eTextile/Matrix/Software/README.md

# E256 - Demo software

For an explanation of the E256 communication protocol see the [FIRMWARE_README](../Firmware/README.md "FIRMWARE_README")

- [Pure_data](http://puredata.info/downloads "puredata.info")
  - SLIP-OSC driver
    - This patch depends on several third party externals available through deken plugin (Help -> Find externals):
	- comport : 
	- mrpeach : OSC slipenc and slipdec
	- cyclone : 
- [openFrameworks](https://openframeworks.cc/ "openFrameworks.cc")
  - SLIP-OSC driver
- [Supercollider](https://supercollider.github.io/ "Supercollider.io") - FIXME
  - SLIP-OSC driver
- [Processing](https://processing.org/ "Processing.org") - TODO
  - SLIP-OSC driver
- [MaxMSP](https://cycling74.com/ "cycling74.com") - TODO
  - SLIP-OSC driver
- [VVVVV](https://vvvv.org/downloads "vvvv.org") - TODO?
  - SLIP-OSC driver

# E256 data stream samples (SLIP-OSC)

Sample input:
Code:
~~~~```
INPUT (tree blobs) : 
35 98 117 110 100 108 101 0 0 0 0 0 0 0 0 0 0 0 0 20 47 98 0 0 44 98 0 0 0 0 0 7 0 1 44 49 6 12 181 0 0 0 0 20 47 98 0 0 44 98 0 0 0 0 0 7 1 1 18 27 10 10 221 0 0 0 0 20 47 98 0 0 44 98 0 0 0 0 0 7 2 1 40 32 6 10 203 0
```

~~~~```
0 	: 35 = "#"
1 	: 98 = "b"
2 	: 117 = "u"
3 	: 110 = "n"
4 	: 100 = "d"
5 	: 108 = "l"
6 	: 101 = "e"
7 	: O
8 	: 0
9 	: 0
10 	: 0
11  : 0
12  : 0
13  : 0
14  : 0
15  : 0
16  : 0
17  : 0
18  : 0
19  : 20
20  : 47 = "/"
21  : 98 = "b"
22  : 0
23  : 0
24  : 44
25  : 98
26  : 0
27  : 0
28  : 0
29  : 0
30  : 0
31  : 7
32  : BYTE -> UID
33  : BYTE -> alive
34  : BYTE -> Xcentroid
35  : BYTE -> Ycentroid
36  : BYTE -> box.H
37  : BYTE -> box.W
38  : BYTE -> box.D
39  : 0
40  : 0
41  : 0
42  : 0
43  : 20
44  : 47 = "/"
45  : 98 = "b"
...

```

# E256 data stream samples (SLIP-OSC)

~~~~```
print: 35 98 117 110 100 108 101 0 0 0 0 0 0 0 0 0
print: 35 98 117 110 100 108 101 0 0 0 0 0 0 0 0 0
print: 35 98 117 110 100 108 101 0 0 0 0 0 0 0 0 0
print: 35 98 117 110 100 108 101 0 0 0 0 0 0 0 0 0
print: 35 98 117 110 100 108 101 0 0 0 0 0 0 0 0 0
print: 35 98 117 110 100 108 101 0 0 0 0 0 0 0 0 0
print: 35 98 117 110 100 108 101 0 0 0 0 0 0 0 0 0
print: 35 98 117 110 100 108 101 0 0 0 0 0 0 0 0 0
print: 35 98 117 110 100 108 101 0 0 0 0 0 0 0 0 0
print: 35 98 117 110 100 108 101 0 0 0 0 0 0 0 0 0
print: 35 98 117 110 100 108 101 0 0 0 0 0 0 0 0 0
print: 35 98 117 110 100 108 101 0 0 0 0 0 0 0 0 0 0 0 0 20 47 98 0 0 44 98 0 0 0 0 0 7 0 1 44 47 6 10 154 0
print: 35 98 117 110 100 108 101 0 0 0 0 0 0 0 0 0 0 0 0 20 47 98 0 0 44 98 0 0 0 0 0 7 0 1 44 46 6 9 153 0
print: 35 98 117 110 100 108 101 0 0 0 0 0 0 0 0 0 0 0 0 20 47 98 0 0 44 98 0 0 0 0 0 7 0 1 44 47 7 10 162 0
print: 35 98 117 110 100 108 101 0 0 0 0 0 0 0 0 0 0 0 0 20 47 98 0 0 44 98 0 0 0 0 0 7 0 1 43 47 8 10 175 0
print: 35 98 117 110 100 108 101 0 0 0 0 0 0 0 0 0 0 0 0 20 47 98 0 0 44 98 0 0 0 0 0 7 0 1 44 47 6 11 188 0
print: 35 98 117 110 100 108 101 0 0 0 0 0 0 0 0 0 0 0 0 20 47 98 0 0 44 98 0 0 0 0 0 7 0 1 44 49 6 12 197 0
print: 35 98 117 110 100 108 101 0 0 0 0 0 0 0 0 0 0 0 0 20 47 98 0 0 44 98 0 0 0 0 0 7 0 1 44 49 6 12 191 0
print: 35 98 117 110 100 108 101 0 0 0 0 0 0 0 0 0 0 0 0 20 47 98 0 0 44 98 0 0 0 0 0 7 0 1 44 49 7 12 188 0
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
print: 35 98 117 110 100 108 101 0 0 0 0 0 0 0 0 0 0 0 0 20 47 98 0 0 44 98 0 0 0 0 0 7 0 1 44 49 6 12 178 0 0 0 0 20 47 98 0 0 44 98 0 0 0 0 0 7 1 1 18 27 10 10 217 0 0 0 0 20 47 98 0 0 44 98 0 0 0 0 0 7 2 1 40 32 6 10 205 0
print: 35 98 117 110 100 108 101 0 0 0 0 0 0 0 0 0 0 0 0 20 47 98 0 0 44 98 0 0 0 0 0 7 0 1 44 49 6 12 181 0 0 0 0 20 47 98 0 0 44 98 0 0 0 0 0 7 1 1 18 27 10 10 220 0 0 0 0 20 47 98 0 0 44 98 0 0 0 0 0 7 2 1 40 32 6 10 205 0
print: 35 98 117 110 100 108 101 0 0 0 0 0 0 0 0 0 0 0 0 20 47 98 0 0 44 98 0 0 0 0 0 7 0 1 44 49 6 12 181 0 0 0 0 20 47 98 0 0 44 98 0 0 0 0 0 7 1 1 18 27 10 10 221 0 0 0 0 20 47 98 0 0 44 98 0 0 0 0 0 7 2 1 40 32 6 10 203 0
```
