eTextile/Matrix/Eagle/eTextile_matrix_sensor.brd

## EAGLE design Eagle/eTextile_matrix_sensor.brd (2016-10-07, last stored version)

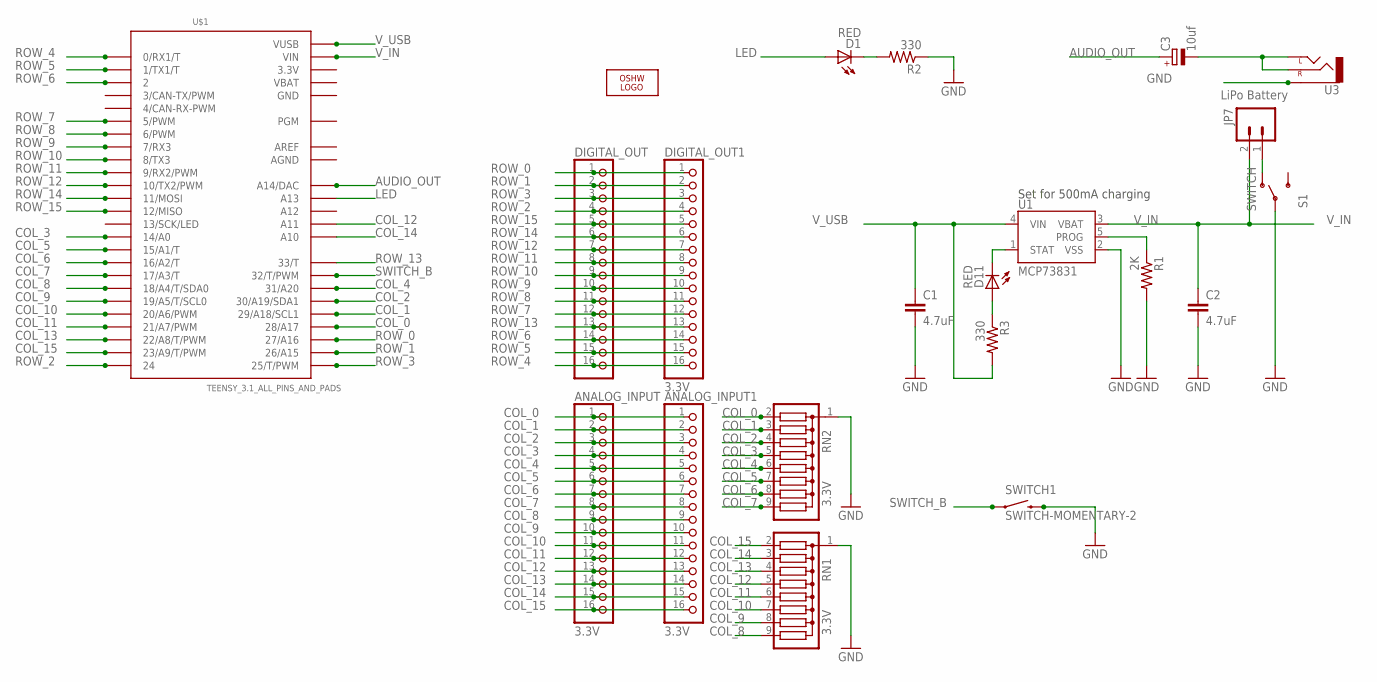
[picture p3: schematic eTextile_matrix_sensor.sch]

Parts:
ANALOG_INPUT: 3.3V; 1X16/90
ANALOG_INPUT1: 3.3V; 1X16
C1, C2: 4.7uF; 0805
C3: 10uf; E1,8-4
D1, D11: RED; LED-1206
DIGITAL_OUT: PINHD-1X16/90; 1X16/90
DIGITAL_OUT1: 3.3V; 1X16/90
JP7: LiPo Battery; JST-2-SMD
LOGO1: OSHW_LOGO_8MILX0350-NT; OSHW_8X350_NOTEXT
R1: 2K; 0805
R2, R3: 330; 0805
RN1, RN2: 3.3V; SIL9
S1: SWITCH; AYZ0202
SWITCH1: SWITCH-MOMENTARY-2; TACTILE_SWITCH_TALL
U1: MCP73831; SOT23-5
U3: AUDIO-JACKSMD2; AUDIO-JACK-3.5MM-SMD
U$1: TEENSY_3.1_ALL_PINS_AND_PADS; TEENSY_3.1_ALLPINS

Connections:
3.3V: U$1.3.3V, U$1.3.3V1 (3.3V), U$1.3.3V2 (3.3V)
AGND: U$1.AGND
AREF: U$1.AREF
AUDIO_OUT: C3.+, U$1.A14 (A14/DAC)
COL_0: ANALOG_INPUT.1, ANALOG_INPUT1.1, RN2.2, U$1.28 (28/A17)
COL_1: ANALOG_INPUT.2, ANALOG_INPUT1.2, RN2.3, U$1.29 (29/A18/SCL1)
COL_2: ANALOG_INPUT.3, ANALOG_INPUT1.3, RN2.4, U$1.30 (30/A19/SDA1)
COL_3: ANALOG_INPUT.4, ANALOG_INPUT1.4, RN2.5, U$1.14/A0
COL_4: ANALOG_INPUT.5, ANALOG_INPUT1.5, RN2.6, U$1.31 (31/A20)
COL_5: ANALOG_INPUT.6, ANALOG_INPUT1.6, RN2.7, U$1.15/A1 (15/A1/T)
COL_6: ANALOG_INPUT.7, ANALOG_INPUT1.7, RN2.8, U$1.16/A2 (16/A2/T)
COL_7: ANALOG_INPUT.8, ANALOG_INPUT1.8, RN2.9, U$1.17/A3 (17/A3/T)
COL_8: ANALOG_INPUT.9, ANALOG_INPUT1.9, RN1.9, U$1.18/A4 (18/A4/T/SDA0)
COL_9: ANALOG_INPUT.10, ANALOG_INPUT1.10, RN1.8, U$1.19/A5 (19/A5/T/SCL0)
COL_10: ANALOG_INPUT.11, ANALOG_INPUT1.11, RN1.7, U$1.20/A6 (20/A6/PWM)
COL_11: ANALOG_INPUT.12, ANALOG_INPUT1.12, RN1.6, U$1.21/A7 (21/A7/PWM)
COL_12: ANALOG_INPUT.13, ANALOG_INPUT1.13, RN1.5, U$1.A11
COL_13: ANALOG_INPUT.14, ANALOG_INPUT1.14, RN1.4, U$1.22/A8 (22/A8/T/PWM)
COL_14: ANALOG_INPUT.15, ANALOG_INPUT1.15, RN1.3, U$1.A10
COL_15: ANALOG_INPUT.16, ANALOG_INPUT1.16, RN1.2, U$1.23/A9 (23/A9/T/PWM)
GND: C1.2, C2.2, R1.2, R2.1, RN1.1, RN2.1, S1.2, SWITCH1.B2 (2), U1.2 (VSS), U3.SLEEVE, U$1.GND, U$1.GND1 (GND), U$1.GND2 (GND)
LED: D1.A, U$1.A13
unnamed: C3.-, U3.RING (RIGHT), U3.TIP (LEFT)
unnamed: D11.A, R3.1
unnamed: JP7.1, S1.1 (O)
unnamed: D1.C, R2.2
PROG: R1.1, U1.5 (PROG)
ROW_0: DIGITAL_OUT.1, DIGITAL_OUT1.1, U$1.27 (27/A16)
ROW_1: DIGITAL_OUT.2, DIGITAL_OUT1.2, U$1.26 (26/A15)
ROW_2: DIGITAL_OUT.4, DIGITAL_OUT1.4, U$1.24
ROW_3: DIGITAL_OUT.3, DIGITAL_OUT1.3, U$1.25 (25/T/PWM)
ROW_4: DIGITAL_OUT.16, DIGITAL_OUT1.16, U$1.0 (0/RX1/T)
ROW_5: DIGITAL_OUT.15, DIGITAL_OUT1.15, U$1.1 (1/TX1/T)
ROW_6: DIGITAL_OUT.14, DIGITAL_OUT1.14, U$1.2
ROW_7: DIGITAL_OUT.12, DIGITAL_OUT1.12, U$1.5 (5/PWM)
ROW_8: DIGITAL_OUT.11, DIGITAL_OUT1.11, U$1.6 (6/PWM)
ROW_9: DIGITAL_OUT.10, DIGITAL_OUT1.10, U$1.7 (7/RX3)
ROW_10: DIGITAL_OUT.9, DIGITAL_OUT1.9, U$1.8 (8/TX3)
ROW_11: DIGITAL_OUT.8, DIGITAL_OUT1.8, U$1.9 (9/RX2/PWM)
ROW_12: DIGITAL_OUT.7, DIGITAL_OUT1.7, U$1.10 (10/TX2/PWM)
ROW_13: DIGITAL_OUT.13, DIGITAL_OUT1.13, U$1.33 (33/T)
ROW_14: DIGITAL_OUT.6, DIGITAL_OUT1.6, U$1.11 (11/MOSI)
ROW_15: DIGITAL_OUT.5, DIGITAL_OUT1.5, U$1.12 (12/MISO)
STAT: D11.C, U1.1 (STAT)
SWITCH_B: SWITCH1.A2 (1), U$1.32 (32/T/PWM)
VBAT: U$1.VBAT
V_IN: C2.1, JP7.2, U1.3 (VBAT), U$1.VIN
V_USB: C1.1, R3.2, U1.4 (VIN), U$1.VUSB

Notes on the sheet:
Set for 500mA charging

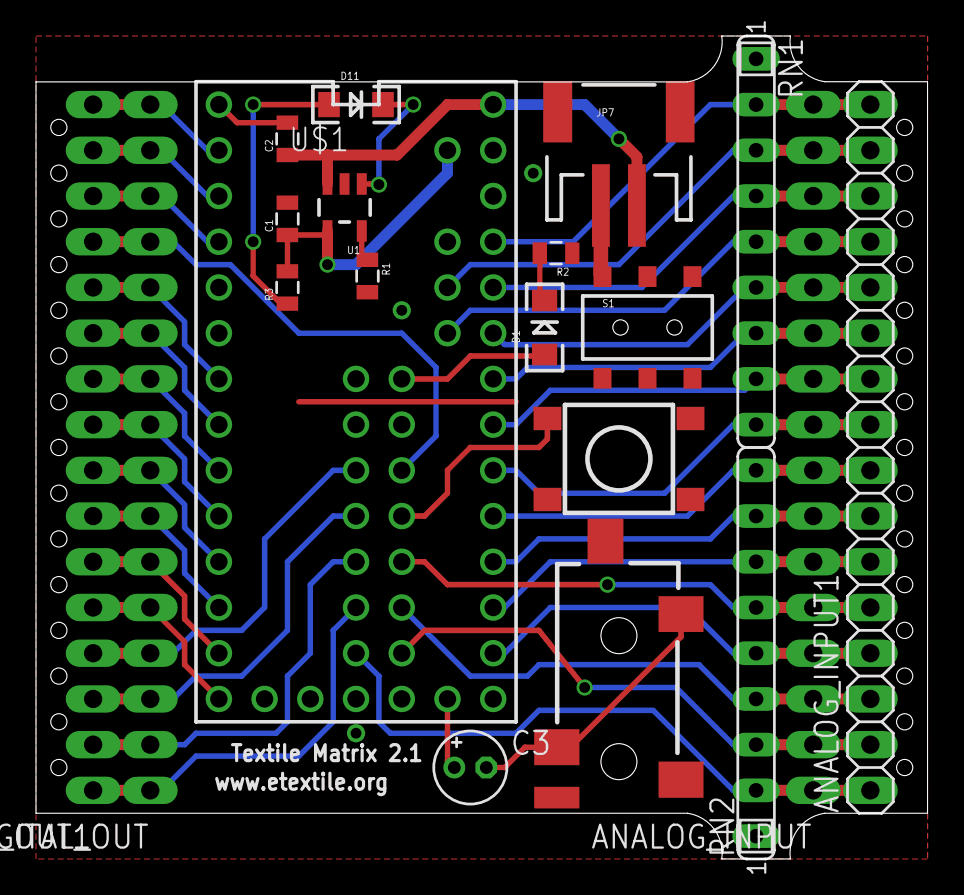
[picture p4: board eTextile_matrix_sensor.brd from above]

Board: 2 copper layers, 49.5 x 45.7 mm, 21 parts (0 on the bottom side), 45 nets.
