eTextile/Matrix/Eagle/Arduio_matrix-shield_02.brd

## EAGLE design Eagle/Arduio_matrix-shield_02.brd (2014-09-01, last stored version)

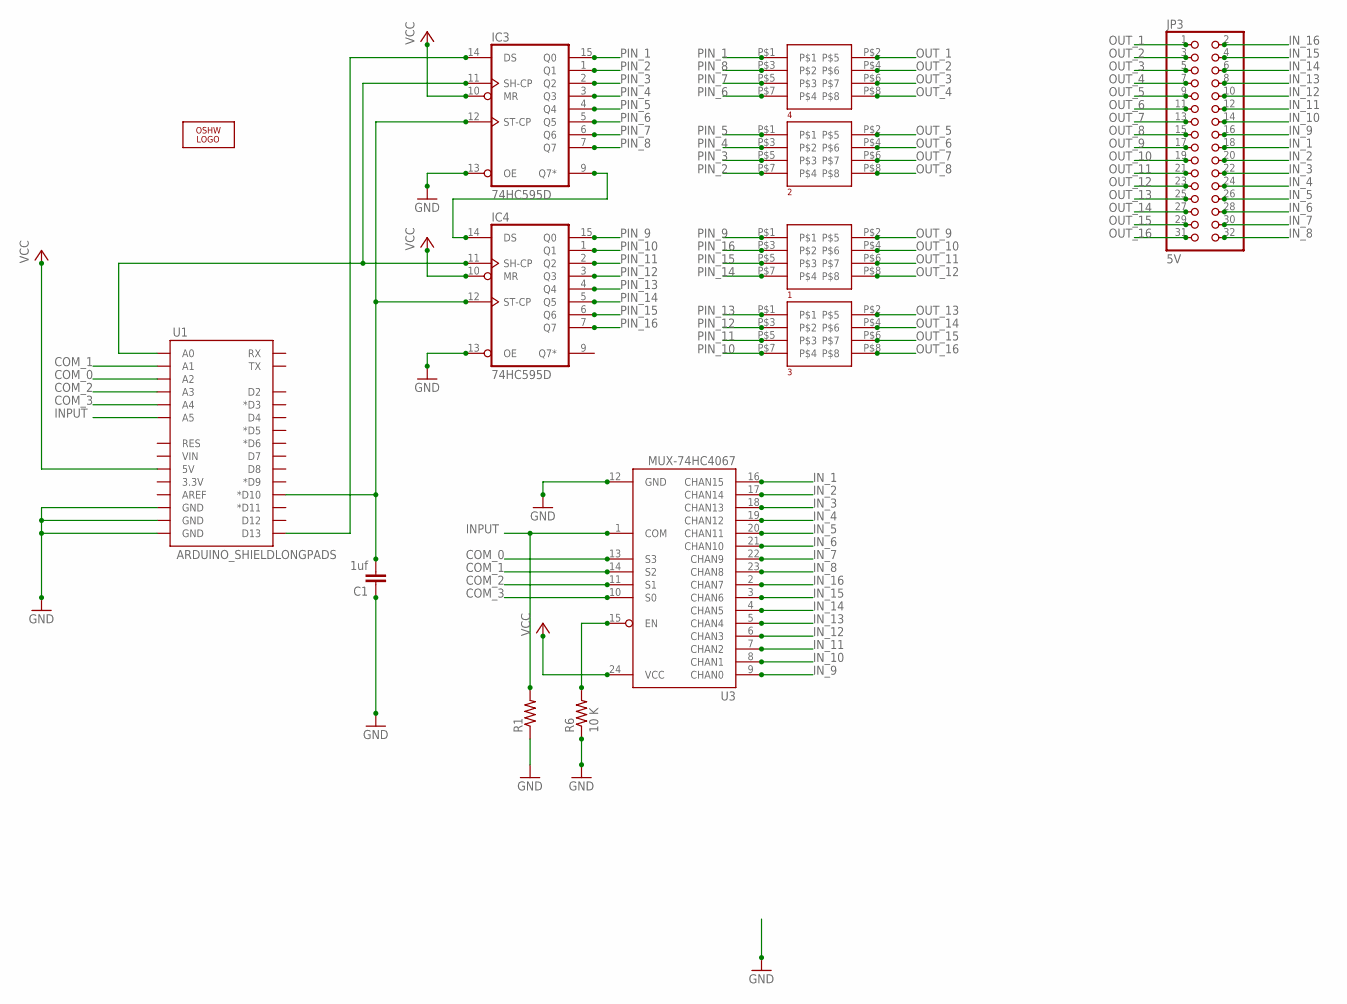
[picture p5: schematic Arduio_matrix-shield_02.sch]

Parts:
1, 2, 3, 4: D83A
C1: 1uf; 1206
IC3, IC4: 74HC595D; SO16
JP3: 5V; 2X16/90
OSHW: OSHW_LOGO_8MILX0350-NT; OSHW_8X350_NOTEXT
R1: R-US_0204/7; 0204/7
R6: 10 K; 1206
U1: ARDUINO_SHIELDLONGPADS; DUEMILANOVE_SHIELD_LONGPADS
U3: MUX-74HC4067; SSOP24

Connections:
COM_0: U1.A2, U3.13 (S3)
COM_1: U1.A1, U3.14 (S2)
COM_2: U1.A3, U3.11 (S1)
COM_3: U1.A4, U3.10 (S0)
GND: C1.1, IC3.8 (GND), IC3.13 (OE), IC4.8 (GND), IC4.13 (OE), R1.1, R6.1, U1.GND@0 (GND), U1.GND@1 (GND), U1.GND@2 (GND), U3.12 (GND)
INPUT: R1.2, U1.A5, U3.1 (COM)
IN_1: JP3.18, U3.16 (CHAN15)
IN_2: JP3.20, U3.17 (CHAN14)
IN_3: JP3.22, U3.18 (CHAN13)
IN_4: JP3.24, U3.19 (CHAN12)
IN_5: JP3.26, U3.20 (CHAN11)
IN_6: JP3.28, U3.21 (CHAN10)
IN_7: JP3.30, U3.22 (CHAN9)
IN_8: JP3.32, U3.23 (CHAN8)
IN_9: JP3.16, U3.9 (CHAN0)
IN_10: JP3.14, U3.8 (CHAN1)
IN_11: JP3.12, U3.7 (CHAN2)
IN_12: JP3.10, U3.6 (CHAN3)
IN_13: JP3.8, U3.5 (CHAN4)
IN_14: JP3.6, U3.4 (CHAN5)
IN_15: JP3.4, U3.3 (CHAN6)
IN_16: JP3.2, U3.2 (CHAN7)
unnamed: IC3.9 (Q7*), IC4.14 (DS)
unnamed: R6.2, U3.15 (EN)
unnamed: IC3.11 (SH-CP), IC4.11 (SH-CP), U1.A0
unnamed: C1.2, IC3.12 (ST-CP), IC4.12 (ST-CP), U1.D10 (*D10)
unnamed: IC3.14 (DS), U1.D13
OUT_1: 4.P$2, JP3.1
OUT_2: 4.P$4, JP3.3
OUT_3: 4.P$6, JP3.5
OUT_4: 4.P$8, JP3.7
OUT_5: 2.P$2, JP3.9
OUT_6: 2.P$4, JP3.11
OUT_7: 2.P$6, JP3.13
OUT_8: 2.P$8, JP3.15
OUT_9: 1.P$2, JP3.17
OUT_10: 1.P$4, JP3.19
OUT_11: 1.P$6, JP3.21
OUT_12: 1.P$8, JP3.23
OUT_13: 3.P$2, JP3.25
OUT_14: 3.P$4, JP3.27
OUT_15: 3.P$6, JP3.29
OUT_16: 3.P$8, JP3.31
PIN_1: 4.P$1, IC3.15 (Q0)
PIN_2: 2.P$7, IC3.1 (Q1)
PIN_3: 2.P$5, IC3.2 (Q2)
PIN_4: 2.P$3, IC3.3 (Q3)
PIN_5: 2.P$1, IC3.4 (Q4)
PIN_6: 4.P$7, IC3.5 (Q5)
PIN_7: 4.P$5, IC3.6 (Q6)
PIN_8: 4.P$3, IC3.7 (Q7)
PIN_9: 1.P$1, IC4.15 (Q0)
PIN_10: 3.P$7, IC4.1 (Q1)
PIN_11: 3.P$5, IC4.2 (Q2)
PIN_12: 3.P$3, IC4.3 (Q3)
PIN_13: 3.P$1, IC4.4 (Q4)
PIN_14: 1.P$7, IC4.5 (Q5)
PIN_15: 1.P$5, IC4.6 (Q6)
PIN_16: 1.P$3, IC4.7 (Q7)
VCC: IC3.10 (MR), IC3.16 (VCC), IC4.10 (MR), IC4.16 (VCC), U1.5V, U3.24 (VCC)

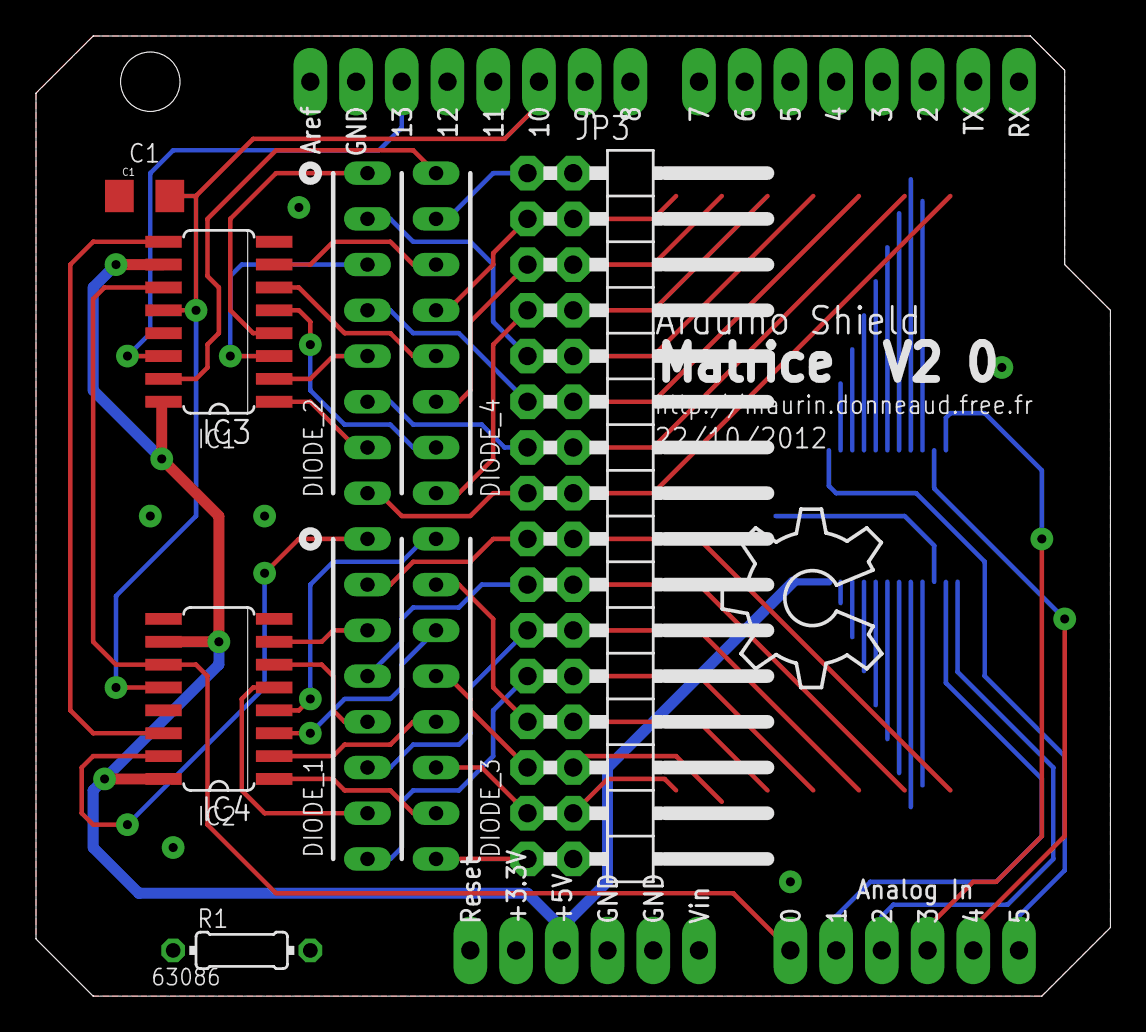
[picture p6: board Arduio_matrix-shield_02.brd from above]

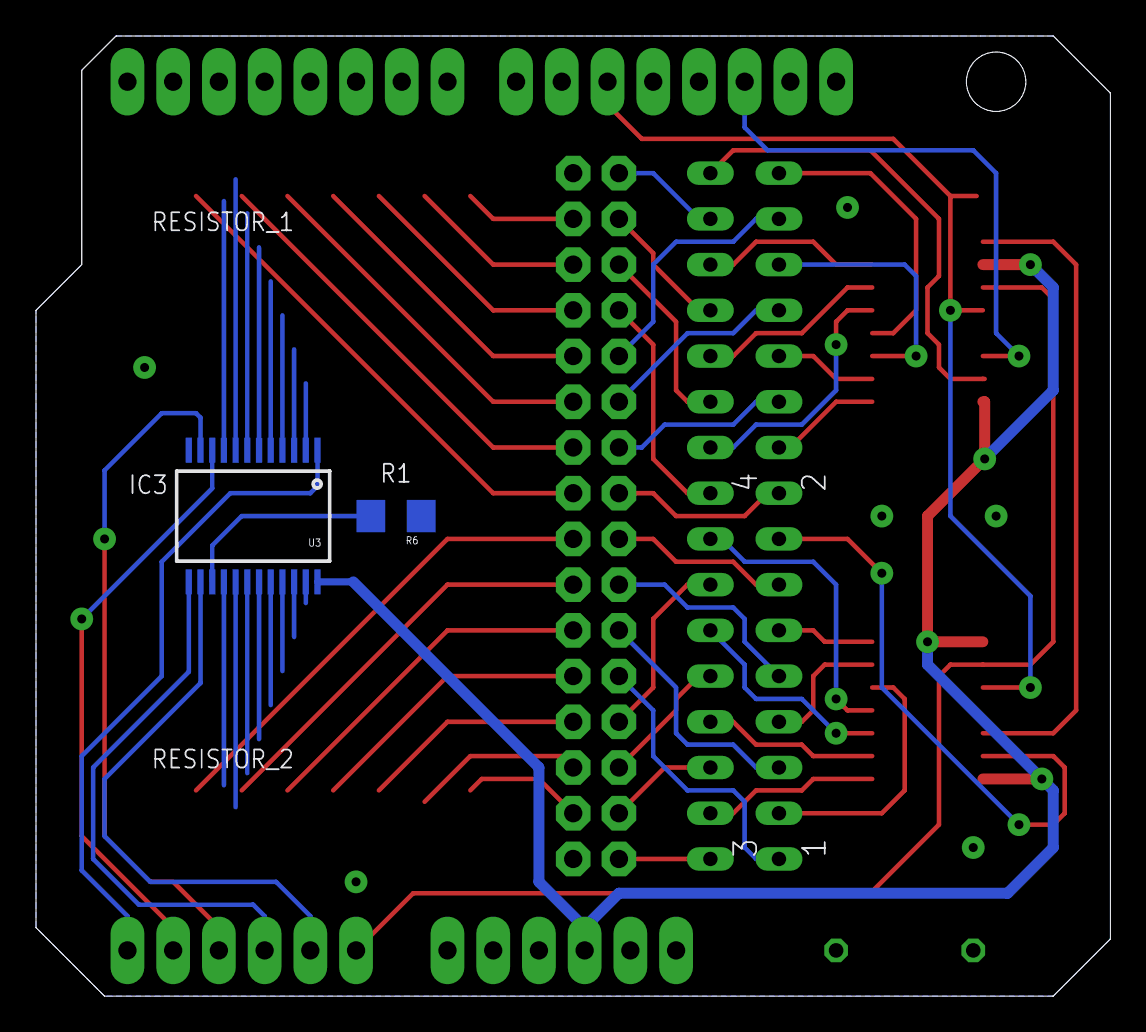
[picture p7: board Arduio_matrix-shield_02.brd from below]

Board: 2 copper layers, 59.7 x 53.3 mm, 13 parts (6 on the bottom side), 60 nets.
