eTextile/Matrix/Software/openFrameworks/src/ofApp.h

#pragma once

#include "ofMain.h"
#include "ofxSerial.h"
#include "ofxOsc.h"
#include "ofxGui.h"
#include "ofxOsc.h"

#define USB_PORT              "/dev/ttyACM0"
#define BAUD_RATE             230400  // With Teensy, it's always the same native speed. The baud rate setting is ignored.
#define RAW_COLS              16
#define RAW_ROWS              16
#define DUAL_ROWS             (RAW_ROWS / 2)
#define SCALE_X               4
#define SCALE_Y               4
#define RAW_FRAME             (RAW_COLS * RAW_ROWS)
#define NEW_COLS              (RAW_COLS * SCALE_X)
#define NEW_ROWS              (RAW_ROWS * SCALE_Y)
#define NEW_FRAME             (NEW_COLS * NEW_ROWS)

#define OUT_BUFFER_SIZE       1024
#define IN_BUFFER_SIZE        65535

//#define HOST                "192.168.0.101"
#define HOST                  "localhost"
#define UDP_OUTPUT_PORT       7771
#define UDP_INPUT_PORT        1234

struct blob {
  uint8_t UID;
  uint8_t alive;
  uint8_t Xcentroid;
  uint8_t Ycentroid;
  uint8_t boxW;
  uint8_t boxH;
  uint8_t boxD;
};

struct serialMessage {
    std::string OSCmessage;
    std::string exception;
};

using namespace ofxIO;

class ofApp: public ofBaseApp {

public:
    void                          setup(void);
    void                          update(void);
    void                          draw(void);
    void                          exit(void);
    char                          requestBuffer[OUT_BUFFER_SIZE];

    void                          onSerialBuffer(const ofxIO::SerialBufferEventArgs& args);
    void                          onSerialError(const ofxIO::SerialBufferErrorEventArgs& args);

    ofxIO::SLIPPacketSerialDevice serialDevice;
    std::vector<serialMessage>    serialMessages; // SerialMessages is a vector of SerialMessage
    std::vector<ofxOscMessage>    blobs;

    //ofxOscBundle                  OSCbundle;
    serialMessage                 message;
    bool                          serialRawData;
    bool                          serialBlobs;
    ofxPanel                      gui;
    ofxButton                     setCalirationButton; // Button to calibrate E256
    ofxIntSlider                  setTresholdSlider; // Set E256 threshold value
    ofxToggle                     getBlobsToggle;
    ofxToggle                     getRawDataToggle;
    ofxToggle                     getInterpDataToggle;
    ofxToggle                     getBinDataToggle;

    uint8_t                       inputFrameBuffer[IN_BUFFER_SIZE];
    uint8_t                       rawValues[RAW_FRAME];    // 1D array (16*16)
    uint8_t                       interpValues[NEW_FRAME]; // 1D array (64*64)
    uint8_t                       binValues[NEW_FRAME];    // 1D array (64*64)

    void                          E256_setCaliration(void);
    void                          E256_setTreshold(int & sliderValue);

    bool                          getRawData;
    bool                          getInterpData;
    bool                          getBinData;
    bool                          getBlobs;

    void                          E256_rawDataRequestStart(bool & val);
    void                          E256_interpDataRequestStart(bool & val);
    void                          E256_binDataRequestStart(bool & val);
    void                          E256_blobsRequestStart(bool & val);

    bool                          E256_dataRequest;
    void                          E256_rawDataRequest(void);
    void                          E256_interpDataRequest(void);
    void                          E256_binDataRequest(void);
    void                          E256_blobsRequest(void);

    ofMesh                        rawDataMesh;
    ofMesh                        interpDataMesh;

		ofTrueTypeFont	              FreeSansBold;
    void                          keyPressed(int key);
   ofxOscSender                   sender;
    //std::vector<ofboxPrimitive>  boxe;

/*
    #define COMPUTE_BINARY_IMAGE_ROW_PTR(pBitmap, y) \
    ({ \
      __typeof__ (pBitmap) _pBitmap = (pBitmap); \
      __typeof__ (y) _y = (y); \
      ((uint8_t*)_pBitmap->pData) + (((_pBitmap->numCols + UINT8_T_MASK) >> UINT8_T_SHIFT) * _y); \
    })
*/

  };
