eTextile/Matrix/(commit log)

2014-10-03 complete rewrite of the project
    [Arduio_matrix-shield_02.brd, Arduio_matrix-shield_02.sch]
2016-10-07 New project 16x16 matrix sesors
    [Keyboard_teensy_00.brd, Keyboard_teensy_00.sch, eTextile_matrix_sensor.brd, eTextile_matrix_sensor.sch]
2016-10-25 Add debug print enabling flag.
2016-10-31 New : fixed fps at 60Hz for better performances
    [ofApp.cpp]
2016-10-31 Clean : aesthetics, wrong link...
    [ofApp.cpp]
2016-10-31 New : OSC input for debug use without Arduino device
2016-10-31 New : /reset message
    [ofApp.cpp]
2016-12-12 Fix : open frameworks 0.9.8 compatibility
    [ofApp.h]
2017-01-12 Fix potentially jerky display.
    [ofApp.cpp]
2017-06-21 new electronic PCB
    [eTextile_matrix_sensor.brd, eTextile_matrix_sensor.sch]
2017-06-21 Added the E256 Arduino driver
2017-06-23 Updated calibration fonction & clean up
2017-07-07 added .svg for printing
2017-08-24 Added Arduino CMSIS bilinear interpolation example
2017-08-25 Added new PCB picture
2017-08-28 Update for the Teensy Prototype version
2017-09-06 Updating calibration()
2017-09-06 Updated calibration()
2017-09-13 trying to get rid of micropython in order to compile the blob tracking with arduino IDE. How can i replace the memory allocation functions py/gc.c used in the code.
2017-09-19 Added framebuffer.c framebuffer.h
2017-09-25 Updated calibrate() & renamed fonctions
2017-09-28 Tryng to fix #includes
    [llist.h]
2017-10-02 Added gitignore for build-teensy & build-uno
2017-10-03 Added pin mapping for E-256 PCB
2017-10-18 WORKING but still some Bugs!!!!!!!
    [config.h]
2017-10-26 The nodes and pointers makes holes in my brain
2017-11-15 the bug start to be quit
    [config.h]
2018-01-23 braked input nead to be fixed
    [config.h]
2018-02-27 ADC input is now set to 8-bit
2018-02-27 Still trying to fix the blob tracking
    [config.h]
2018-02-28 Fix some bugs in the Lifo
    [config.h]
2018-03-02 Lifo is not working properly
    [config.h]
2018-03-09 Added new ADC lib
2018-03-18 Added Dual synchronized ADC
2018-03-18 Added PureData OSC driver
2018-03-23 reorganized files & ADC BUGFIX attempt
    [config.h, llist.cpp, llist.h]
2018-03-26 OSC BUGFIX - Added msg.empty()
    [config.h]
2018-03-27 Added Pure Data OSC driver
2018-03-28 CleanUP PD driver
2018-04-17 Updated 2D linear interpolation : FIXME: outIndex computation
    [config.h, interp.cpp, interp.h]
2018-04-17 Bilinear inerp small fix
    [interp.cpp]
2018-04-18 WIP: bugs fixes: now compiles.
    [interp.h, llist.h]
2018-11-27 Updated openFrameworks driver for SLIP-OSC communication
    [ofApp.cpp, ofApp.h]
2018-12-06 OSC parcing is not fixed
    [ofApp.cpp, ofApp.h]
2018-12-15 Updated SLIP-OSC for blobs communication
    [config.h, llist.cpp]
2018-12-15 Working Driver
2019-01-14 Updatad for new blob definition & new serial SLIP-OSC parsing technique
    [ofApp.cpp, ofApp.h]
2019-04-21 Major update / updated SLIP-OSC packet
    [config.h]
2019-04-21 New driver
2019-04-21 New SLIP-OSC serial driver
    [main.cpp, ofApp.cpp, ofApp.h]
2019-05-10 Added Processing SLIP-OSC sketch (in progress)
    [E256_SLIP_OSC.pde]
2019-05-27 Added raw frame 3D
2019-09-25 Added Bela driver
2020-02-20 Updated Firmware for new ADC lib
2020-02-20 Added new PCB info
2020-02-20 Kicad in progress
2020-04-25 Added puredata simple SLIP-OSC driver
    [ofApp.cpp, ofApp.h]
2021-02-02 Updated board README
