eTextile/Matrix/(notices)

Notices in the files:
Arduino/E256-eTextile_matrix_sensor/E256-eTextile_matrix_sensor.ino:
PACKET SERIAL : Copyright (c) 2012-2014 Christopher Baker <http://christopherbaker.net>
parts and their libraries:
SparkFun: Licensing: CC v3.0 Share-Alike You are welcome to use this library for commercial purposes.
